TomasOndrisak/stu-project/docs/linky.txt

https://www.tsbohemia.sk/amd-wraith-stealth-chladic-cpu_d374817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

https://techfun.sk/produkt/chladic-peltier-clankov-pre-chladenie-vodou/

https://techfun.sk/produkt/peltier-clanok/?attribute_pa_peltier=tec1-12715

https://www.conrad.sk/sk/p/arctic-mx-4-actcp00024a-teplovodiva-pasta-45-g-2841652.html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

https://www.alza.sk/arctic-s4028-6k-d7173088.htm

https://www.conrad.sk/sk/p/ich-hadicova-priechodka-30402-vonkajsi-zavit-1-8-priemer-6-mm-1-ks-584915.html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

https://techfun.sk/produkt/topne-teliesko-50w-12v-24v-pre-3d-tlaciarne/?attribute_pa_pracovne-napatie=12-v

https://techfun.sk/produkt/nepajive-pole-400-bodov/

https://techfun.sk/produkt/dfrobot-vodeodolny-senzor-teploty-ds18b20/

https://techfun.sk/produkt/senzor-prietoku-tekutiny-g1-2/

https://techfun.sk/produkt/dual-mosfet-pwm-regulator-aod4184a/

https://techfun.sk/produkt/potenciometer-rozne-typy-b1k-az-b500k/?attribute_pa_typ-potenciometra=b10k

https://techfun.sk/produkt/arduino-uno-r3-precizny-klon/

https://techfun.sk/produkt/kabliky-40-kusov-20-cm-m-m/

https://techfun.sk/produkt/balenie-rezistorov-20-hodnot-x-20-kusov/

čerpadlo zo starého opla 3€
