TomasOndrisak/stu-project/(commit log)

2026-05-23 Added arduino setup into firmware.
2026-05-23 Added PID with anti windup clamping
2026-05-23 PID and JSON output
2026-05-23 Potentiometer input for pump control + code formating
2026-05-24 dashboard with current values and live updates
2026-05-24 dual charts with chart.js for temperatures and pid actuators
2026-05-24 Setpoint and pump pwm controls with potentiometer toggle
2026-05-25 Added heater PWM control
2026-05-25 Added PID controls
2026-05-25 Added serial-to-MQTT bridge for Arduino communication
2026-05-25 Added arduino state
2026-05-25 Added flow sensor.
2026-05-26 Added timestamp to dashboard and fixed UTC date.
    [database.py]
2026-05-26 Fixed bug + translations.
    [main.ino]
2026-05-26 Flow sensor calibration.
2026-05-28 Added chart for potentiometer and flowsensor. Added sync of controls with arduino.
